Taller-de-diseno-digital-GR01/Proyecto-3-Batalla-Naval/docs/diseño/diagramas/esquematicos/README.md

Scripts que generan los esquemáticos por compuertas del inciso i) de los docs de módulos a partir de los .sv con yosys y netlistsvg.
