Taller-de-diseno-digital-GR01/Proyecto-3-Batalla-Naval/docs/diseño/diagramas/flujo_1.jpg

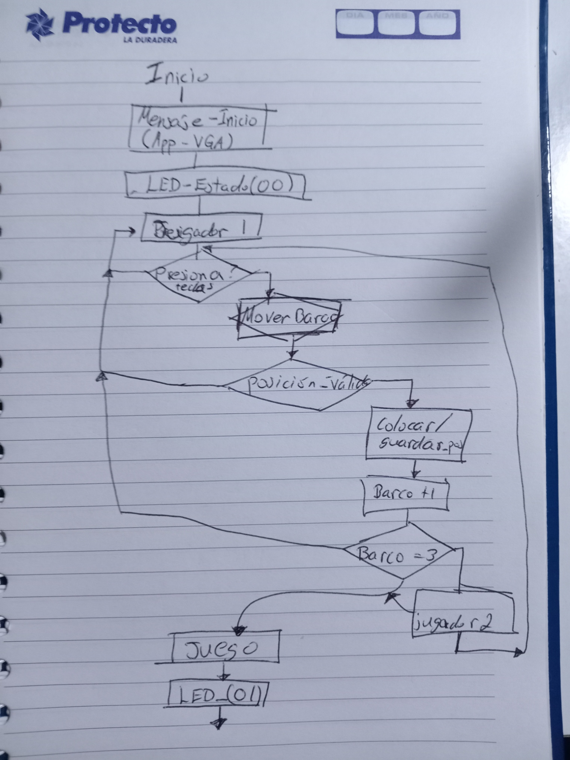
docs/diseño/diagramas/flujo_1.jpg
