Taller-de-diseno-digital-GR01/Proyecto-3-Batalla-Naval/docs/diseño/diagramas/flujo_2.jpg

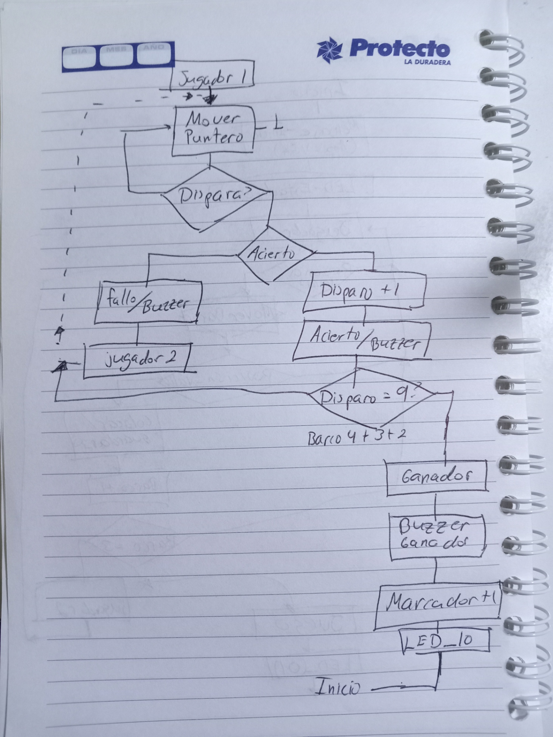
docs/diseño/diagramas/flujo_2.jpg
