Taller-de-diseno-digital-GR01/Proyecto-3-Batalla-Naval/src/design/fuente_caracteres.sv

// ROM de caracteres del periferico VGA, una fuente de 5 x 7 para ASCII de 0x20 a 0x5F.
// codigo_i = ASCII - 32, asi el programa escribe el codigo con la misma cuenta que el ensamblador
// ('A' - 32 = 33). Solo trae espacio, digitos, letras mayusculas y ! - :, el resto sale en blanco.
// Combinacional. El periferico la lee en el dominio de clk_pix_i con el codigo ya registrado.
//
// Cada glifo esta escrito fila por fila, el bit 4 es la columna izquierda. Para agregar un caracter basta
// con sumar sus 7 filas con su codigo.
module fuente_caracteres (
  input  logic [5:0] codigo_i, // ASCII - 32
  input  logic [2:0] fila_i,   // 0 arriba a 6 abajo, la 7 siempre en blanco
  output logic [4:0] bits_o    // [4] columna izquierda, [0] derecha
  );

  always_comb begin
    case ({codigo_i, fila_i})
      // '!', codigo 1
      {6'd1, 3'd0}: bits_o = 5'b00100;
      {6'd1, 3'd1}: bits_o = 5'b00100;
      {6'd1, 3'd2}: bits_o = 5'b00100;
      {6'd1, 3'd3}: bits_o = 5'b00100;
      {6'd1, 3'd4}: bits_o = 5'b00100;
      {6'd1, 3'd5}: bits_o = 5'b00000;
      {6'd1, 3'd6}: bits_o = 5'b00100;
      // '-', codigo 13
      {6'd13, 3'd0}: bits_o = 5'b00000;
      {6'd13, 3'd1}: bits_o = 5'b00000;
      {6'd13, 3'd2}: bits_o = 5'b00000;
      {6'd13, 3'd3}: bits_o = 5'b11111;
      {6'd13, 3'd4}: bits_o = 5'b00000;
      {6'd13, 3'd5}: bits_o = 5'b00000;
      {6'd13, 3'd6}: bits_o = 5'b00000;
      // '0', codigo 16
      {6'd16, 3'd0}: bits_o = 5'b01110;
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
      {6'd55, 3'd6}: bits_o = 5'b01010;
      // 'X', codigo 56
      {6'd56, 3'd0}: bits_o = 5'b10001;
      {6'd56, 3'd1}: bits_o = 5'b10001;
      {6'd56, 3'd2}: bits_o = 5'b01010;
      {6'd56, 3'd3}: bits_o = 5'b00100;
      {6'd56, 3'd4}: bits_o = 5'b01010;
      {6'd56, 3'd5}: bits_o = 5'b10001;
      {6'd56, 3'd6}: bits_o = 5'b10001;
      // 'Y', codigo 57
      {6'd57, 3'd0}: bits_o = 5'b10001;
      {6'd57, 3'd1}: bits_o = 5'b10001;
      {6'd57, 3'd2}: bits_o = 5'b10001;
      {6'd57, 3'd3}: bits_o = 5'b01010;
      {6'd57, 3'd4}: bits_o = 5'b00100;
      {6'd57, 3'd5}: bits_o = 5'b00100;
      {6'd57, 3'd6}: bits_o = 5'b00100;
      // 'Z', codigo 58
      {6'd58, 3'd0}: bits_o = 5'b11111;
      {6'd58, 3'd1}: bits_o = 5'b00001;
      {6'd58, 3'd2}: bits_o = 5'b00010;
      {6'd58, 3'd3}: bits_o = 5'b00100;
      {6'd58, 3'd4}: bits_o = 5'b01000;
      {6'd58, 3'd5}: bits_o = 5'b10000;
      {6'd58, 3'd6}: bits_o = 5'b11111;
      default: bits_o = 5'b00000;
    endcase
  end

endmodule
