Taller-de-diseno-digital-GR01/Proyecto-3-Batalla-Naval/(commit log)

2026-09-22 Archivos de UART no actualizados añadidos
2026-09-22 Documentación vieja de UART añadida
2026-09-22 periferico_uart.sv: el mapa de registros seguia siendo el del P2
2026-09-23 Documentación de PERIFERICO_UART actualizada al P3
2026-09-23 Actualización de árbitro y módulos 10 & 11 del proyecto 2 para proyecto 3
2026-09-23 UART_receptor.md y UART_transmisor.md sin el prefijo de módulo del P2
2026-09-23 documentación del UART mejorada
2026-09-23 agregado diseño de diagrama de primer nivel
2026-09-23 Agregado diseno del diagrama de segundo nivel
2026-09-23 nivel02.md con los bloques internos y el bus de datos
2026-09-24 Nivel 3 listo para el camino de la UART
2026-09-24 Documentación de NUCLEO_UART_TX
2026-09-24 Documentación de NUCLEO_UART_RX terminada
2026-09-24 PERIFERICO_UART.md: el diagrama modular no salia del nivel 3 y la ventana muerta seguia con nombres del vhd
2026-09-24 Títulos de UART_transmisor.md iguales al resto
2026-09-24 Agregado documento de diagrama de nivel 3 sin terminar, falta seccion de VGA y afinar el controlador de mapeos
2026-09-24 Creado el diseño del módulo de Adress Translator
2026-09-25 GENERADOR_TONO portado del P2, solo queda el divisor
2026-09-25 secuenciador_melodia.md con las cinco melodías y la tabla de notas
2026-09-25 Documentación de PERIFERICO_BUZZER terminada
2026-09-25 Esquemático por compuertas de PERIFERICO_UART
2026-09-25 Esquemático por compuertas de generador_tono
2026-09-25 Documentación de PERIFERICO_7SEG terminada
2026-09-25 Scripts de yosys que generan los esquemáticos de la UART
2026-09-25 Ajuste diagrama de VGA
2026-09-25 sintetizar.sh: el grep del final tumbaba uart.sh cuando yosys no imprimia nada
2026-09-25 conos.py: el registro agarraba el nombre de un alias como mascara_ext
2026-09-25 uart.sh dibuja también arbitro, receptor y transmisor del Proyecto 2
2026-09-25 Esquemático por compuertas de ARBITRO_UART
2026-09-25 UART_receptor con su esquemático por compuertas
2026-09-25 Esquemático de UART_transmisor, el reg_len - 1 de 32 bits queda como TODO
2026-09-25 antirrebote.md portado del debounce del P2, el flanco pasa al programa
2026-09-25 Documentación de PERIFERICO_ENTRADAS terminada
2026-09-26 antirrebote.md fuera, los botones de la Basys 3 ya llegan filtrados
2026-09-26 PERIFERICO_ENTRADAS.md sin antirrebote, queda REG_ESTADO y el mux de lectura
2026-09-26 PERIFERICO_LED.md portado de M05_Estado del P2, I/O y decodificación de dirección
2026-09-26 Documentación de PERIFERICO_LED terminada
2026-09-26 Protocolo UART con resincronización por 0xAA y el orden de acceso de la ROM al periférico
2026-09-26 nivel03.md con los bloques internos de PERIFERICO_UART que venían de feature/uart
2026-09-26 nivel01.md juntado con el de feature/uart, señales y pines reales
2026-09-26 PLL y LED aparte en nivel02.md, cada bloque con sus entradas y salidas
2026-09-26 arbitro_uart, receptor_uart y transmisor_uart fuera, en el P3 su trabajo lo hace la ROM
2026-09-26 Docs y esquemáticos del árbitro, receptor y transmisor del P2 fuera, uart.sh solo dibuja los del P3
2026-09-26 nivel03.md: la trama tardaba 434 µs, con la ventana muerta de uart_tx son 520
2026-09-26 PERIFERICO_UART.md: no decía que la escritura que arranca un envío también pisa new_rx
2026-09-26 nivel02.md: decía PLL y el resto de los docs usa un MMCM para los dos relojes
2026-09-26 nivel03.md: los códigos del LED no eran one-hot como espera PERIFERICO_LED
2026-09-26 PERIFERICO_UART.md con uart_we del controlador de mapeo
2026-09-29 PERIFERICO_UART.md: el rango 0x0001_0040 a 0x0001_004F no calzaba con el Address Translator
2026-09-29 nivel02.md: addr_i fijo en 2'b00 para los periféricos de un solo registro
2026-09-29 PERIFERICO_ENTRADAS.md con gpio_we en cero y la dirección exacta del Address Translator
2026-09-29 nivel03.md con el Address Translator y los bloques reales de 7seg, LED y buzzer
2026-09-29 PERIFERICO_7SEG.md con display_we y la dirección exacta del Address Translator
2026-09-29 PERIFERICO_LED.md: la trampa de [31:3] ya no aplica con el Address Translator
2026-09-29 nivel01.md: BTN_OK en btnC y BTN_RST en el botón rojo del Pmod JC
2026-09-29 PERIFERICO_7SEG.md: el marcador solo se borra con rst_i
2026-09-29 PERIFERICO_LED.md sin el TODO del reinicio general
2026-09-29 PERIFERICO_BUZZER.md: BTN_RST lo atiende el programa, no rst_i
2026-09-29 nivel01.md sin el TODO del pin de rst
2026-09-29 PERIFERICO_ENTRADAS.md sin el TODO del botón rojo
2026-09-29 Primer commit para periferico_entradas, I/O listo
2026-09-29 I/O de periferico_led listo
2026-09-29 periferico_led con REG_LEDS y el mux de lectura
2026-09-29 Primer commit para marcador
2026-09-29 Módulo marcador terminado, digitos en BCD y puntos desde el registro
2026-09-29 I/O de periferico_7seg listo
2026-09-29 generador_tono.sv con el contador y el comparador como submódulos
2026-09-29 Primer commit para secuenciador_melodia
2026-09-29 I/O de periferico_buzzer listo
2026-09-30 Scripts de esquemáticos traídos de feature/uart
2026-09-30 Esquemático por compuertas de PERIFERICO_ENTRADAS
2026-09-30 PERIFERICO_LED.md con el esquemático generado desde periferico_led.sv
2026-09-30 Esquemático por compuertas de marcador
2026-09-30 generador_tono.png regenerado desde el .sv real
2026-09-30 Esquemático de secuenciador_melodia, las ROM sin inferir memoria
2026-09-30 PERIFERICO_BUZZER.md con el esquemático por compuertas
2026-09-30 nivel03.md: decía conexiones propuestas y sin RTL en periféricos que ya lo tienen
2026-09-30 nivel03.md con los bloques internos de entradas, 7seg, LED y buzzer
2026-10-01 periferico_uart con CLK_FREQ_HZ y BAUDIOS, los ticks de los núcleos salen de ahí
2026-10-01 PERIFERICO_UART.md con los parámetros nuevos y el error del receptor a relojes más bajos
2026-10-01 nivel02.md: decía que había que recalcular TICKS_BIT y TICKS_X16 a mano
2026-10-01 Actualización de Diseño
2026-10-01 Flujo de ensamblado con binutils de GNU
2026-10-01 programa en Assembly completado + cambios en diseño
2026-10-01 agregado modulo de Address translator y submodulo de mux de lectura junto a sus test benches
2026-10-01 GNUmakefile sin los targets de la app del ahorcado
2026-10-01 rst_i sale de locked del MMCM, el reinicio general es el botón PROG
2026-10-01 target flash para grabar el bitstream en la flash
2026-10-01 nivel01.md con BTN_SEL en btnC, BTN_OK y BTN_RST en switches y PROG de reinicio general
2026-10-01 nivel02.md: rst_i sale de locked del MMCM, no hay pin de reset
2026-10-03 Diseño y Módulo de ROM
2026-10-03 Diseño e Implementación de RAM
2026-10-03 Implementación del núclleo RISC-V con cambios en el Makefile y su tb para pruebas
2026-10-03 enlace y terminal traídos de la app del ahorcado
2026-10-03 protocolo.py con las tramas de nivel03
2026-10-03 vista de los dos tableros
2026-10-03 partida.py: Colocar barco salía con vertical en el lugar de la fila
2026-10-03 pruebas de protocolo y partida
2026-10-03 targets app y test-app de vuelta en el GNUmakefile
2026-10-04 espaciado de 1 ms entre bytes de cada trama
2026-10-05 Testbench de uart_tx traído del Proyecto 2
2026-10-05 Testbench de uart_rx listo
2026-10-05 Testbench de periferico_uart listo
2026-10-05 Testbench de periferico_entradas listo
2026-10-05 Testbench de periferico_led listo
2026-10-05 Testbench de periferico_7seg listo
2026-10-05 Testbench de periferico_buzzer listo
2026-10-06 revisión de cst completa
2026-10-07 Docs y comentarios a clk_i de 33,33 MHz con PLL, buzzer en JC4
    [basys3.xdc, enlace.py, periferico_buzzer.sv, periferico_vga.sv]
2026-10-07 terminal.py: hjkl para mover el cursor
2026-10-07 Tableros escalados al tamaño de la terminal
2026-10-08 Readme modificado con instrucciones de ejecución del juego y estructura
2026-10-08 Actualización de Diseños con respecto a los códigos reales
2026-10-08 Doc de Diseño completo
2026-10-08 Linter, simulación del netlist de síntesis, fichas de top y PLL
2026-10-09 tb_top_temporizado compila con Icarus 13 y guarda el PC en la onda
    Icarus 13 se caía (assertion en draw_eval_vec4) con los ?: entre "" y $sformatf de revisar_salto,
    ahora van con if. xsim no acepta cables del netlist en $dumpvars, así que el reloj, el reinicio,
    el PC, la instrucción y el sonido se copian a cables del testbench.
2026-10-09 Informe: simulación post-implementación, timing actual y README
    - Sección 10.7 completa: implementación con Vivado, testbench, UART a 694444 baudios, resultado
    de las 19 pruebas sobre el netlist con SDF y dos figuras de la onda (arranque y disparo del J1).
    - Resumen, validación, resultados, problemas (P14 a P17), análisis crítico y conclusiones sin la
    simulación pendiente, y 15 testbenches en lugar de 14.
    - Recursos y timing de nextpnr de la versión actual: 4788 LUT y clk_sys a 37,92 MHz.
    - README: make sim-post, Vivado como dependencia opcional y cómo compilar Icarus 13.
2026-10-09 Informe: log de xsim de la simulación post-implementación como evidencia
    El log completo de la corrida queda en docs/informe/evidencia/ y la sección 10.7 lo enlaza.
    .gitignore deja pasar los .log de esa carpeta.
2026-10-09 Log de evidencia sin datos de la máquina
    Se quita el encabezado de xsim (equipo, usuario, procesador, memoria) y la ruta absoluta del
    $finish queda relativa al repo. La salida de la simulación no cambia.
2026-10-09 Informe: enlace al video de comprobación en la sección 10.6
2026-10-09 Saca del repo el proyecto de Vivado project_3_battleship
    Es el proyecto que crea la GUI de Vivado y entró con la simulación post-implementación. El flujo
    del repo no lo usa: make sim-post corre Vivado en modo batch con src/fpga/vivado_timesim.tcl. Queda
    en .gitignore junto con los .xpr.
2026-10-09 Informe: estilo de redacción
    Sin separadores entre secciones, sin negritas de etiqueta y sin dos puntos como separador dentro
    de las oraciones. Las listas de puertos, pines, decisiones, avisos del linter, resultados en la
    tarjeta y problemas pasan de tabla a viñetas. Se quitan contrastes del tipo "X, no Y" y la versión
    documentada apunta al commit 9e83b8b, el último que cambia código.
2026-10-09 Informe: fotos de la tarjeta en la sección 10.6
    Fase de colocación en el monitor VGA con la app de PC, y la Basys 3 con las ganadas 00 01 en los
    displays.
2026-10-09 Informe: ecuaciones en bloques math para que GitHub las compile
    Los bloques $$ pasaban por Markdown antes de MathJax. La línea que empezaba con + se leía como
    lista y partía la ecuación, y se perdían escapes como \_ y \,. Las comas decimales van como {,}
    para que no salga un espacio después.
2026-10-09 Informe: \mathrm en lugar de \operatorname, que GitHub no permite
